emanuelepaiano/emabot/README.md

<h1>Emabot</h1>
<h2>A robot mobile with Raspberry Pi and Arduino (italian tutorials)</h2>

<div style="float:left">
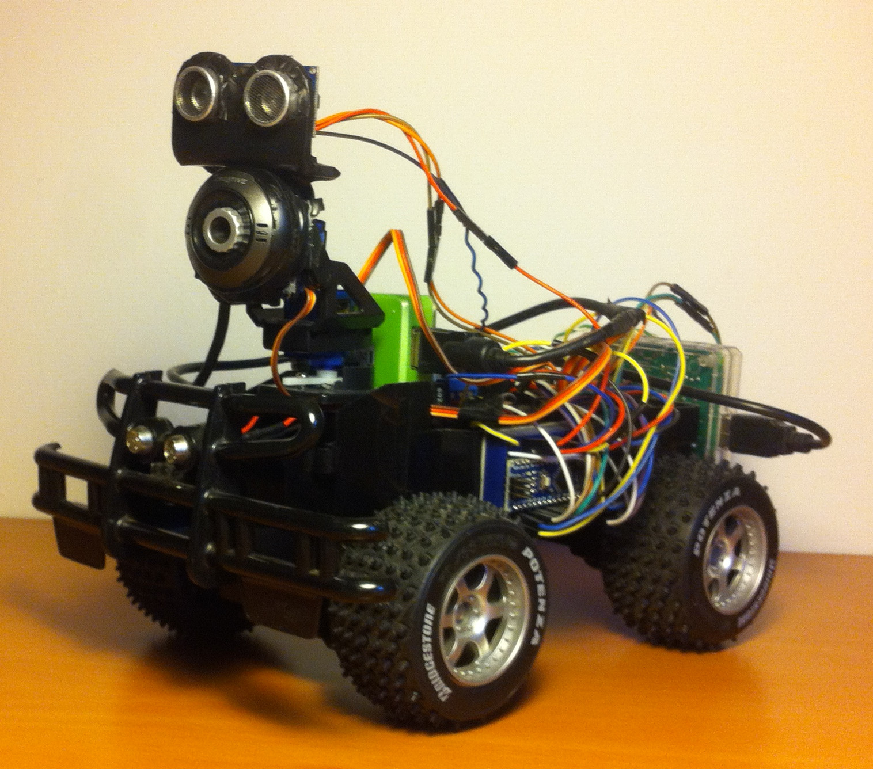
[picture p1: screenshots/01.jpg]

</div>

<div style="float:left">
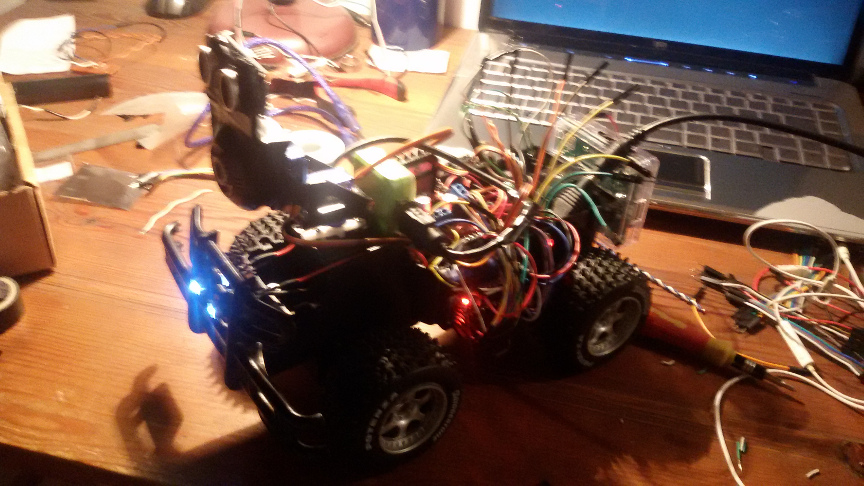
[picture p2: screenshots/06.jpg]
&nbsp
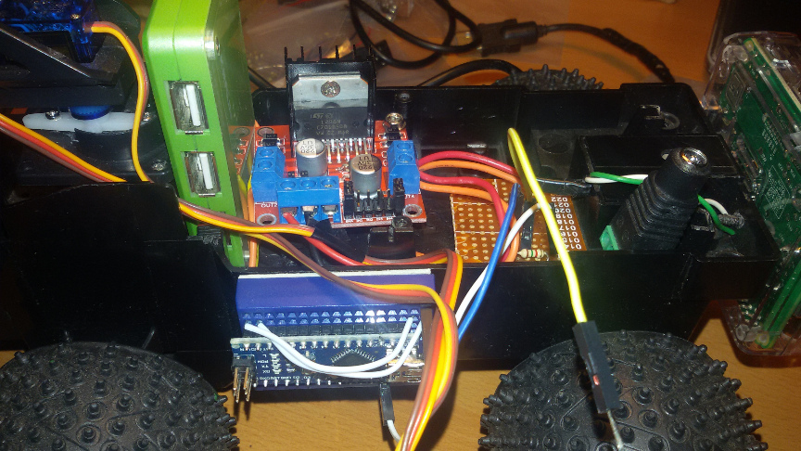
[picture p3: screenshots/07.jpg]
&nbsp
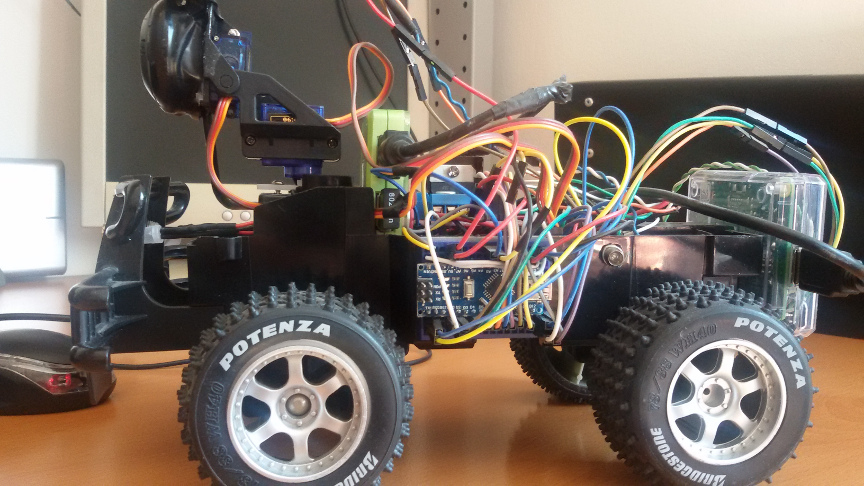
[picture p4: screenshots/08.jpg]
&nbsp
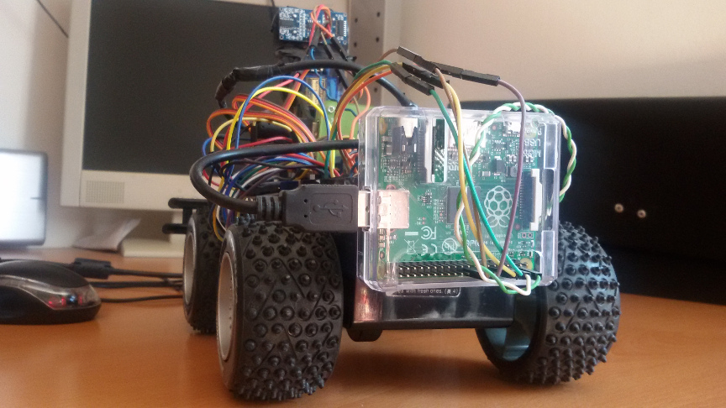
[picture p5: screenshots/09.jpg]
&nbsp

</div>

<h6>Youtube video</h6>
https://www.youtube.com/embed/CbBROWYHJkE

<h6>Tutorials</h6>
<p>Emabot Part1 ITA - 
<a href="https://github.com/emanuelepaiano/emabot/blob/master/Emabot_ITA_part%201.pdf">pdf</a>, 
<a href="https://github.com/emanuelepaiano/emabot/blob/master/markdown/robot_raspberry.markdown">markdown</a>
</p>
