emanuelepaiano/emabot/Emabot_ITA_part 1.pdf

## Costruire un robot mobile con Raspberry Pi e Arduino

Emanuele Paiano

27 aprile 2017

### 1 Licenza

L’autore declina ogni responsabilità relativa alle eventuali conseguenze (hardware danneggiato o altro) delle informazioni contenute nel presente articolo. E’ consentita la stampa, diffusione e riproduzione del testo integrale, purchè venga citata la fonte e l’autore. I sorgenti del progetto sono coperti dai termini della licenza GNU-GPL3 e possono essere riutilizzati per altri progetti non commerciali. Per eventuali chiarimenti potete contattare l’autore all’indirizzo nixw0rm@gmail.com.

### 2 Introduzione

Con l’evoluzione delle varie board di sviluppo e dei sistemi embedded, oggi è estremamente facile assemblare piccoli robot programmabili. E’ possibile tirar su delle piattaforme hardware che ci consentono di sperimentare diversi tipi di algoritmi per la robotica, come la navigazione o il semplice controllo remoto. Se consideriamo i costi contenuti dei vari componenti in commercio, ci rendiamo conto che il progetto diventa ancora più realizzabile e alla portata di molte tasche.
Intuitivamente, possiamo paragonare un semplice robot mobile ad un piccolo computer dotato di sensori e attuatori: i primi sono dispositivi di input in grado di percepire lo stato dell’ambiente, mentre i secondi possiamo considerarli dei dispositivi di output che modificano tale stato (compresa la posizione del robot), in base a delle istruzioni contenute in memoria.

1

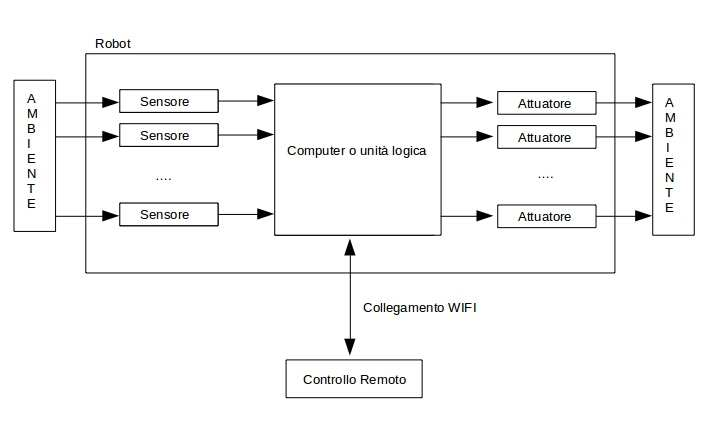
[picture p14: figure]

Prendendo spunto da una mia esperienza personale, in questa serie di articoli vedremo come realizzarne uno, equipaggiato con:

- sensori ultrasuoni per riconoscere gli ostacoli,
- webcam USB dotata di servomotori,
- altoparlante per permettergli di parlare pronunciando delle frasi preimpostate.

Il telaio può essere recuperato da una vecchia macchina radiocomandata oppure è possibile acquistarne uno già pronto. Il nostro robot avrà in tutto 4 ruote e due motorini: due posteriori per la trazione e due anteriori per lo sterzo, il quale viene gestito da un singolo motorino. La board di riferimento è Raspberry Pi accompagnata da Arduino Nano per una gestione più efficiente dei motori.
Il controllo remoto, consiste in un server tcp che gestisce i singoli comandi ricevuti da uno smartphone o pc (su cui gira il client), mentre per il flusso della webcam si farà uso di un server http per lo streaming video.
All’eventuale domanda sul perchè non ci si limita ad Arduino, la risposta metterebbe in evidenza tutti i vantaggi di avere installato Linux in un robot: Raspbian lo rende scalabile e flessibile, permettendo di aggiungere o implementare diverse funzionalità aggiuntive, tra cui:
- far parlare il robot installando espeak, noto sintetizzatore vocale per linux;
- configurare un server vpn e fare in modo che il robot venga gestito fuori dalla nostra rete locale;
- implementare un piccolo sistema di sorveglianza remota direttamente nel robot, con notifica email per eventuali movimenti sospetti (rendendolo un «robot da guardia»).

2

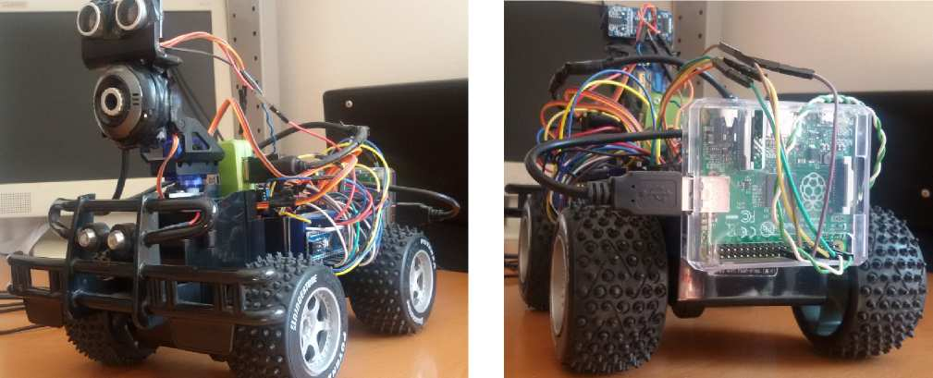
[picture p15: figure]

Figura 1: Un robot mobile realizzato con Raspberry

- possiamo scegliere, tra i linguaggi supportati da raspberry, quello che ci fa più comodo per scrivere il server;
- fare quasi tutto quello che si può fare con un raspberry (immaginate di dare un comando vocale al robot per riprodurre un mp3 in memoria).

Implementare tali caratteristiche con un microcontrollore, appare molto più complesso. Il prezzo da pagare si riversa sui consumi energetici che saranno decisamente maggiori.

### 2.1 Una prima versione: un Raspberry con le ruote

Il primo passo è quello di assemblare un «Raspberry dotato di ruote e webcam». Per ora ignoriamo servomotori e sensori, che saranno aggiunti successivamente. La lista del materiale occorrente prevede:

- Un Raspberry A+, ma andrebbe bene qualunque versione, tenendo conto però, che le versioni B e B+ hanno consumi energetici più elevati (600mAh contro 1500-3000mAh);
- Un dongle Wifi per connettere il raspi ad una rete wireless o per impostarlo come access point. Tale componente non è necessario se usiamo Raspberry Pi 3 (ha la wifi integrata);
- Un hub usb con almeno 3 porte: una per connettere la cam, un’altra per l’adattatore wifi e una di riserva. Tale componente è indispensabile se usiamo il Raspberry A+, in quanto quest’ultimo dispone di una sola porta usb;
- Un Arduino Nano, comandato da Raspberry, si occuperà di gestire il modulo motori ed eventuali attuatori aggiuntivi (luci e servomotori per la webcam).

3

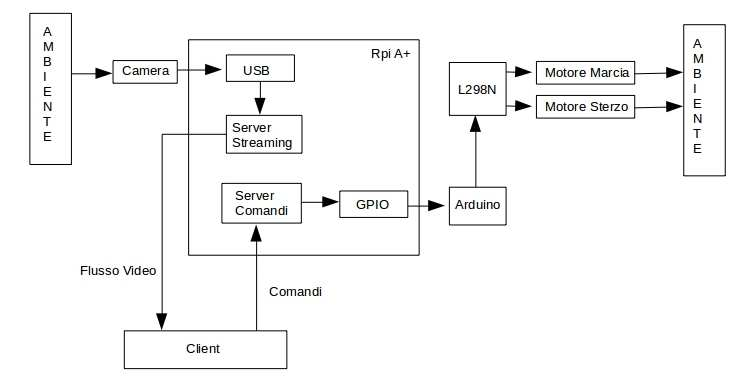
[picture p16: figure]

Figura 2: Schema di funzionamento della prima versione del robot

- Un modulo L298N che permette di gestire i motori di marcia e sterzo, oltre che ad alimentare Arduino;
- Un convertitore di livello per far comunicare Raspberry e Arduino. Raspberry lavora a 3.3 V, mentre Arduino a 5. Se non si converte tale voltaggio, si rischia di danneggiare seriamente il Raspi. Come alternativa, i più esperti potranno far uso di un partitore di tensione;
- Batteria ricaricabile da 9-12 Volt e 2500mAh. Per i test iniziali, è possibile utilizzare un alimentatore universale per notebook impostato a 12 Volt;
- Un DC Step-Down per ridurre i 12 Volt in ingresso in 5 Volt per Raspberry. Come alternativa, i più esperti potranno realizzare un regolatore di tensione apposito, utilizzando un LM7805. Ovviamente tutte le masse (GND) andranno collegate tra loro altrimenti non funzionerà nulla.

ALTERNATIVA

- Una batteria lipo da 7,4V per Arduino / Motori e un Powerbank da 5V per Raspberry, ricordando di collegare la massa (GND) del Raspberry a quella di Arduino.

Per avere un’idea del funzionamento generale del del robot, basta fare riferimento allo schema in Figura 2
Tale schema è intuitivo: la webcam è collegata ad una porta USB di Raspberry, Arduino al GPIO del raspi e i motori al modulo L298N che a sua volta sarà collegato ad Arduino. Il motivo per cui non si collega il modulo direttamente al GPIO, è dovuto al fatto che Raspberry non è un sistema realtime (a meno

4

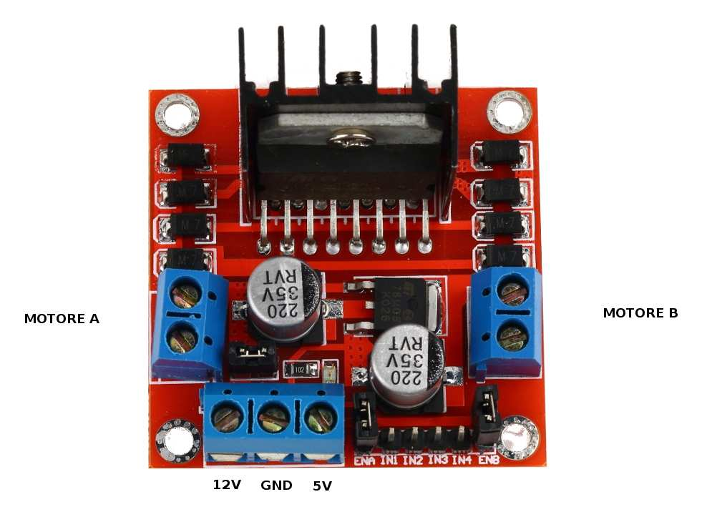
[picture p17: figure]

Figura 3: Il modulo L298N

che non si faccia uso di schede aggiuntive): ciò lo rende instabile di fronte a task che devono essere eseguiti e terminati in intervalli di tempo limitati. Infatti, può succedere che il sistema operativo dia maggiore priorità a processi che non riguardano la gestione dei motori, causando una risposta ritardata ai comandi ricevuti (per esempio, il robot potrebbe sterzare in ritardo). Arduino fa da tramite riducendo le operazioni da eseguire, quindi raspberry dovrà limitarsi ad inviare i comandi sulla porta seriale, al resto ci pensa il microcontrollore. Delegando la gestione degli attuatori, si risolve il problema dell’instabilità, dovuta all’impiego di un sistema che non sia realtime. Altre alternative (già pronte) sono le schede HAT, fatte appositamente per permettere a Raspberry di supportare Servo e Motori CC senza problemi, purtroppo tali schede non sono a disposizione dell’autore. Andiamo a vedere nel dettaglio come saranno effettuati i collegamenti di Arduino al modulo L298N.

### 2.2 Collegamento motori

La prima componente da assemblare è la parte relativa ad Arduino e i Motori CC (la parte più a destra dello schema in Figura 2), seguito dalla realizzazione di un semplice sketch. Prima di procedere, diamo un’occhiata alle caratteristiche del modulo motori.

### 2.2.1 Il modulo L298N

Il modulo L298N (figura 3), detto anche H-Bridge, è un modulo utilizzabile per la gestione dei motori a corrente continua. Esso è composto da un ingresso a 12 Volt, due uscite a 3 V per i motori, e un’uscita a 5 Volt per alimentare la scheda di controllo. Purtroppo, quest’ultima, non può essere utilizzata per alimentare

5

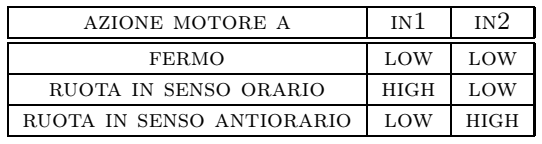
[picture p18: figure]
azione motore a; fermo; low; ruota in senso orario; high; ruota in senso antiorario

Tabella 1: Valori degli ingressi per pilotare il motore A

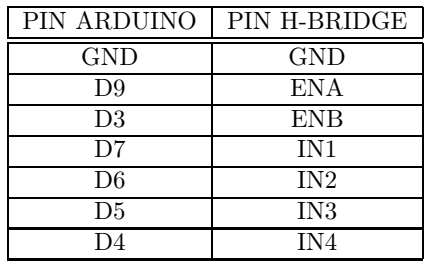
[picture p19: figure]
PIN ARDUINO; PIN H-BRIDGE; GND; ENA; ENB

Tabella 2: Collegamento pin tra H-Bridge e Arduino

Raspberry (l’amperaggio fornito è insufficiente) ma va benissimo per Arduino. Tuttavia, non sarà utilizzata per le fasi di test, infatti ad Arduino collegheremo solo la massa (GND) ma non l’alimentazione, in quanto il microcontrollore sarà alimentato dalla stessa porta USB del PC. Gli ingressi per la gestione dei motorini sono:

- Enable Motor A (ENA): E’ l’ingresso utilizzato per impostare il PWM del motore A, quindi anche la sua velocità. Se messo in corto con il pin superiore (5V+), la velocità rimarrà constante (al valore massimo). Diversamente, possiamo regolare gli impulsi da Arduino e farla variare (sfruttando il Duty Cycle); (https://it.wikipedia.org/wiki/Duty_cycle)
- Enable Motor B (ENB): vale lo stesso discorso di ENA, ma per il motore B.
- Gli ingressi IN1 e IN2 funzionano come mostrato in Tabella 1. Lo stesso discorso vale per IN3 e IN4, solo che viene gestito il motore B.

### 2.2.2 Montaggio e sketch

I collegamenti da effettuare tra i pin di Arduino e quelli del H-Bridge sono descritti in Tabella 2
In Figura 4 possiamo vedere lo schema completo. Il motore cc utilizzato è il Mabuchi FA130 a 3V (spesso presente nei giocattoli elettrici, come trenini e macchine da pista polistil), ma il modulo ne supporta anche altri tipi. Montato il circuito, possiamo pensare all’implementazione dello sketch di Arduino.

6

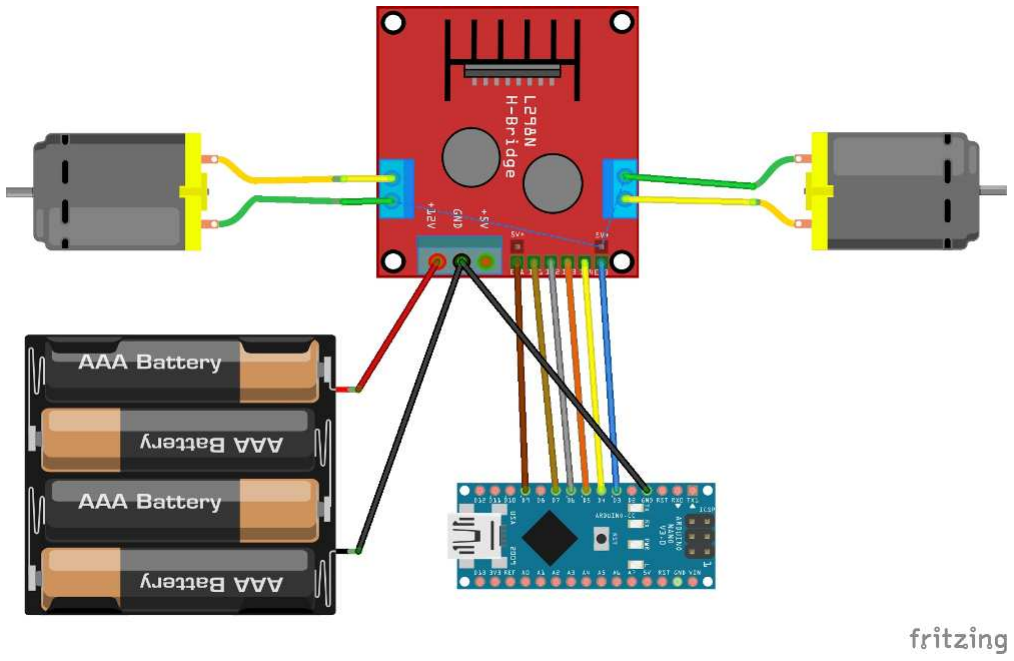
[picture p20: figure]

Figura 4: Collegamento di Arduino al modulo L298N.

7

Le funzioni che utilizzeremo sono analogWrite() per impostare il valore di ENA e quello di ENB, mentre digitalWrite() lo utilizzeremo per inviare i valori HIGH e LOW agli altri pin.
Il codice seguente è lo sketch da caricare in Arduino.

1 /∗
2 | ∗ | Car Ardu ino s im pl e s k e t c h
3 | ∗ | 2015 − | Emanuele Paiano
4 ∗/
5 | /∗ | Primo motore ∗/
6 const int enA = 9 ;
7 const int i n 1 = 7 ;
8 const int i n 2 = 6 ;
9
10 | /∗ | Secondo motore ∗/
11 const int enB = 5 ;
12 const int i n 3 = 7 ;
13 const int i n 4 = 4 ;
14
15 | /∗ | Massimo v a l o r e PWM mo tor ino d i Marcia ∗/
16 const int kMaxPwm=200;
17
18 /∗ v a l o r e PWM S t e r z o ∗/
19 const int kWheelPwm=150;
20
21 /∗ SpeedVal Max . Massimo v a l o r e d e l l e "marce" ∗/ 22 const int kMaxSpeed=5;
23
24 /∗ SpeedVal a t t u a l e ( in g e r g o marc ia ) ∗/
25 int cu r r en tSpeed =4;
26

### 27 void s e tup ( ) {

28 | /∗ | U s c i t e Modulo L298N ∗/
29 pinMode ( enA , OUTPUT) ;
30 pinMode ( enB , OUTPUT) ;
31 pinMode ( in1 , OUTPUT) ;
32 pinMode ( in2 , OUTPUT) ; 33 pinMode ( in3 , OUTPUT) ;
34 pinMode ( in4 , OUTPUT) ;
35
36 | /∗ | I n i z i a l i z z o l a comun icaz ione s e r i a l e usb a 9600 b i t /
s e c ∗/
37 S e r i a l . be gin ( 9 6 0 0 ) ;
38
39 | /∗ | Svuo to i l b u f f e r d e l l a s e r i a l e ∗/
40 S e r i a l . f l u s h ( ) ;

8

41 }
42
43

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

### 49 switch( c )

50 {
51 | /∗ | se ho l e t t o una ’A ’ vado a v a n t i ∗/

### 52 case ’A ’ :

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

### 57 case ’ a ’ :

58 r e v e r s e ( ) ;
59 S e r i a l . p r i n t l n ( "REVERSE OK" ) ;
60 break ;
61 | /∗ | se ho l e t t o una ’ s ’ mi fermo ∗/

### 62 case ’ s ’ :

63 stopMotorA ( ) ;
64 S e r i a l . p r i n t l n ( "STOP OK" ) ;
65 break ;
66
67 | /∗ | se ho l e t t o una ’L ’ g i r o a Des tra ∗/

### 68 case ’L ’ :

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

### 74 case ’ l ’ :

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

### 80 case ’ S ’ :

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

### 86 case ’+’ :

9

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

### 92 case ’−’ :

93 cu r r en tSpeed −−;
94 cu r r en tSpeed=c o n s t r a i n ( cu r r en tSpeed , 1 ,
| | kMaxSpeed ) ;
95 S e r i a l . p r i n t l n ( cu r r en tSpeed ) ;
96 break ;
97 }
98 }
99 }
100
101 /∗ Avan t i ∗/
102 void f o rw a r d ( ) {
103 stopMotorA ( ) ;
104 d i g i t a lW r i t e ( in1 , HIGH) ;
105 d i g i t a lW r i t e ( in2 , LOW) ;
106 a n al o gW ri te ( enA , ge tSpeedVal ( cu r r en tSpeed ) ) ; 107 }
108
109 /∗ recu pe r a c o r r e t t o v a l o r e d i v e l o c i t à ∗/
110 int ge tSpeedVal ( int v al u e )
111 {
112 int v al =0, mult=kMaxPwm/kMaxSpeed ;
113 v al u e=c o n s t r a i n ( value , 0 , kMaxSpeed ) ; 114 v al=v al u e ∗mult ;
115 v al=c o n s t r a i n ( val , 0 , kMaxPwm) ;
116 return v al ;
117 }
118
119 /∗ i n v e r t i marc ia ∗/
120 void r e v e r s e ( ) {
121 stopMotorA ( ) ;
122 d i g i t a lW r i t e ( in2 , HIGH) ;
123 d i g i t a lW r i t e ( in1 , LOW) ;
124 a n al o gW ri te (enA , ge tSpeedVal ( cu r r en tSpeed ) ) ; 125 }
126
127 /∗ Ferma motore d i marc ia ∗/
128 void stopMotorA ( ) {
129 d i g i t a lW r i t e ( in1 , LOW) ; 130 d i g i t a lW r i t e ( in2 , LOW) ;
| | 10

131 a n al o gW ri te ( enA , 0 ) ; 132 }
133
134 /∗ S t e r z o a d e s t r a ∗/ 135 void tu r nRi g h t ( ) {
136 s t r a i g h t ( ) ;
137 d el a y ( 1 0 0 ) ;
138 a n al o gW ri te ( enB , kWheelPwm ) ; 139 d i g i t a lW r i t e ( in3 , HIGH) ;
140 d i g i t a lW r i t e ( in4 , LOW) ;
141 }
142
143 /∗ s t e r z o a s i n i s t r a ∗/
144 void t u r n L e f t ( ) {
145 s t r a i g h t ( ) ;
146 d el a y ( 1 0 0 ) ;
147 a n al o gW ri te ( enB , kWheelPwm ) ; 148 d i g i t a lW r i t e ( in3 , LOW) ;
149 d i g i t a lW r i t e ( in4 , HIGH) ;
150 }
151
152 /∗ r a d d r i z z a s t e r z o ∗/
153 void s t r a i g h t ( ) {
154 d i g i t a lW r i t e ( in3 , LOW) ; 155 d i g i t a lW r i t e ( in4 , LOW) ;
156 a n al o gW ri te ( enB , 0 ) ;
157 }
| Il funzionamento del programma è relativamente semplice: i comandi sono
semplici caratteri ricevuti sulla porta seriale e, in base al byte ricevuto, viene richiamata una funzione corrispondente ad un’azione da eseguire (forward, reverse, turnLeft, turnRight, stop e straight). I comandi possono essere riassunti in Tabella 3.

I possibili livelli di velocità variano da 1 a 5. Si è preferito usare questi valori fittizzi (anzicchè quelli compresi tra 0 a 255), per semplificare l’aumento e la riduzione della velocità utilizzando i caratteri ’+’ e ’-’. Il livello iniziale è 4, in quanto se c’è scarsa trazione, il robot non si muove. Inoltre, per allungarne la vita, si è preferito impostare a 200 il limite massimo del pwm di marcia e a 150 quello dello sterzo: valori più alti sono inutili, data la struttura della nostra macchina (dare troppa potenza al motorino dello sterzo potrebbe essere dannoso).
Per verificare se abbiamo fatto tutto correttamente, possiamo collegare Arduino alla porta usb del PC, alimentiamo il modulo (tramite alimentatore o

11

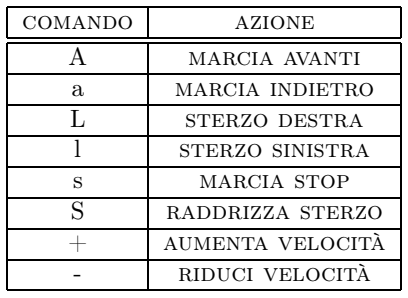
[picture p21: figure]
comando; azione; A marcia avanti; marcia indietro; L sterzo destra; sterzo sinistra; marcia stop; S raddrizza sterzo; aumenta velocità; - riduci velocità

Tabella 3: Comandi da inviare ad Arduino

pin arduino | converter hv | converter lv | pin raspi

Tabella 4: Collegamento UART arduino-convertitore-raspberry.

batterie) e proviamo ad inviare i caratteri con il monitor seriale dell’ide di Arduino, impostando la velocità a 9600bps. Se i motorini girano, e il modulo risponde correttamente ai comandi, allora possiamo passare alla tappa successiva: il collegamento del Raspberry.

### 2.3 Collegare il Raspberry

Per collegare il Raspberry, abbiamo bisogno di un convertitore dei livelli di tensione (Figura 5, in alto a destra), in particolare sul pin di ricezione del raspi (UART_RXD). L’elenco dei Pin è visibile in Figura 5.
Il collegamento da realizzare è di tipo UART: consiste nel collegare il Pin TX di Arduino al Pin UART_RXD di Raspberry, e il pin UART_TXD al pin RX di Arduino come mostrato in figura 6, facendo riferimento ai pin in Tabella 4. Il metodo è molto simile a quello della costruzione di un cavo null modem, ma le controparti hanno livelli di tensione differenti (Arduino lavora a 5V, mentre Raspberry a 3,3).
Collegato il raspberry, non resta che collegare anche il pin vin di Arduino al pin 5V del modulo L298N (staccate arduino dalla usb del pc), come mostrato in figura 7. Per alimentare raspberry, possiamo usare un alimentatore da smartphone (purchè sia a 5V), almeno per le fasi di test. Successivamente, si farà uso di un modulo dc step down: si prenderà parte della tensione globale del sistema, e la si ridurrà a 5 V per Raspberry. In questo modo, avremo due diramazioni a partire dalla sorgente a 12V: una a 5V per Raspberry e l’altra a

### 12 per alimentare il modulo motori (insieme al microcontrollore). L’importante

è che fate arrivare almeno 9V (meglio 12) e 2400mAh in ingresso.

12

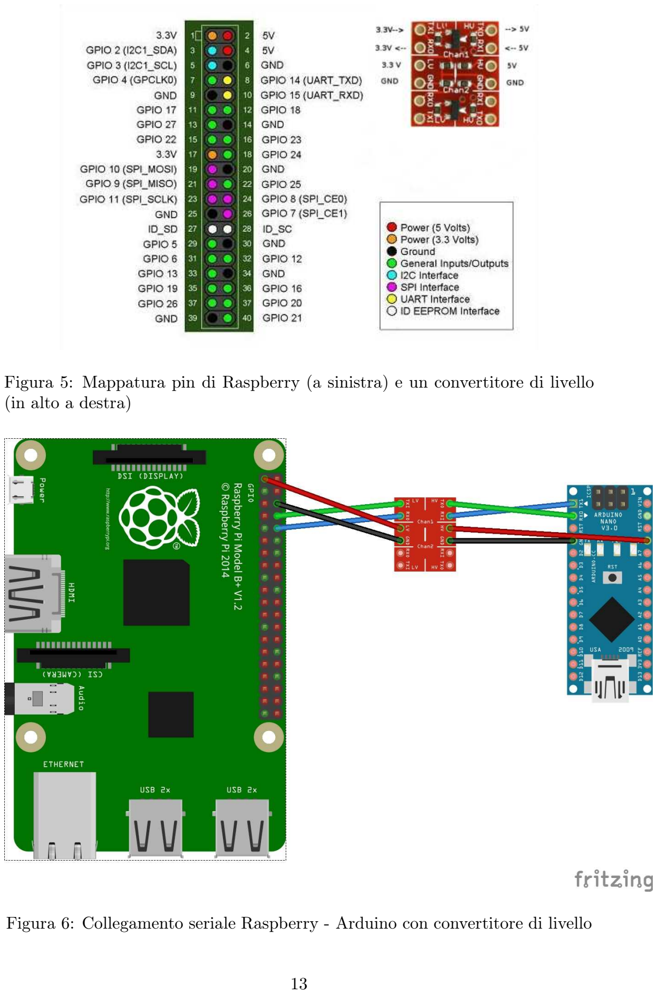
[picture p22: page 13]

Figura 5: Mappatura pin di Raspberry (a sinistra) e un convertitore di livello (in alto a destra)

Figura 6: Collegamento seriale Raspberry - Arduino con convertitore di livello

13

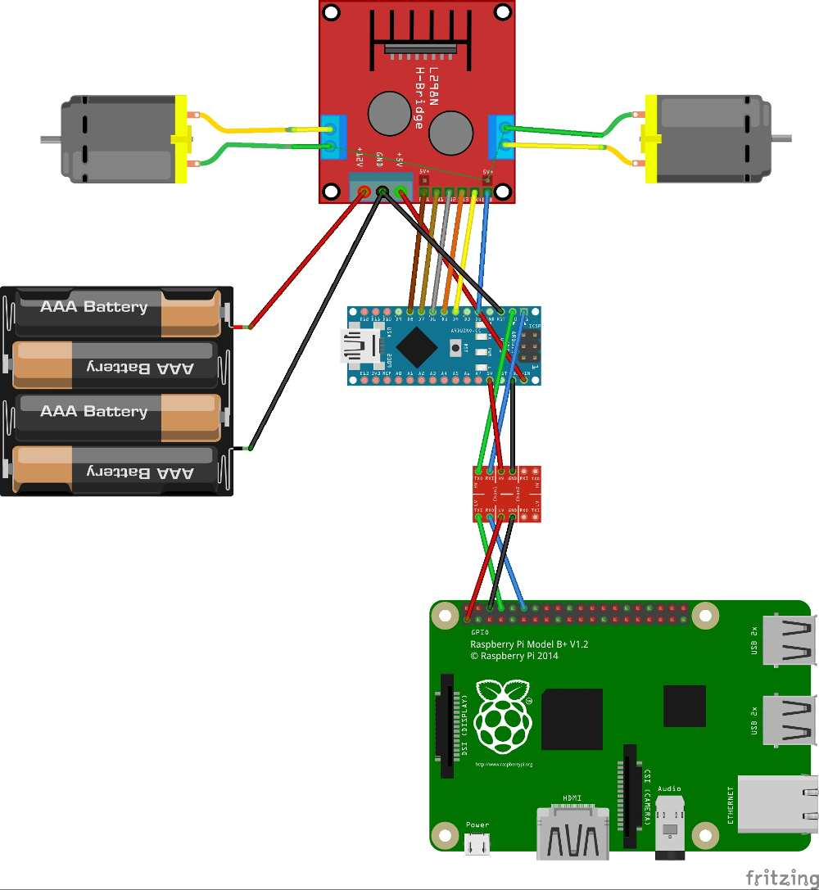
[picture p23: figure]

Figura 7: Il circuito nel complesso: Arduino alimentato direttamente dall’H-bridge, mentre Raspberry sarà alimentato a parte. Da non dimenticare il collegamento GND di raspberry a quello di tutto il circuito.

14

### 2.4 Prima configurazione e test del collegamento

Dopo aver configurato Raspbian, ci limiteremo a testare i motorini da Raspbian. Forse, non tutti sanno che sulla linea seriale UART, di default c’è un attivo un processo getty che permette il login: dobbiamo disattivarlo o il nostro circuito avrà dei malfunzionamenti. Per fare ciò apriamo il file /etc/inittab e troviamo la stringa

T0 : 2 3 : respawn : / s bi n / g e t t y −L ttyAMA0 115200 v t1 0 0

possiamo disattivarla aggiungendo il carattere # per commentarla

#T0 : 2 3 : respawn : / s bi n / g e t t y −L ttyAMA0 115200 v t1 0 0

e salviamo il file. Inoltre, quando raspbian si avvia, tutte le informazioni vengono inviate sulla porta seriale, in quanto tale parametro viene passato al boot. Per disattivarlo, apriamo il file /boot/cmdline.txt e troviamo la riga simile a questa

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

e rimuoviamo tutti i riferimenti a ttyAMA0, nel nostro caso la riga diventa

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

salviamo il file e riavviamo raspberry. Ovviamente tali impostazioni possono variare da una versione all’altra di raspbian, ma spesso sono simili. Ora si lancia minicom sulla porta /dev/ttyAMA0 con una velocità a 9600bps:

minicom −b 9600 −o −D / dev /ttyAMA0

digitando i comandi, possiamo inviare i caratteri e vedere i motorini funzionare.

### 2.5 Riepilogo e conclusioni

Siamo partiti dal collegare i motori al modulo L298N. Abbiamo realizzato uno sketch per Arduino che riceve caratteri ascii e genera segnali high e low da mandare al modulo motori, per poi interfacciare tutto con raspberry in modo da ricevere i comandi da minicom.
A questo punto, possiamo pensare alla parte applicativa: l’idea è quella di scrivere un insieme di librerie e classi in un linguaggio che, agendo sul file /dev/ttyAMA0, gestisca i servo della cam e i motori di marcia. Si potrebbe pensare di scrivere una classe per ogni sensore e attuatore, in modo tale da arrivare a programmare il robot in stile oop, arrivando anche ad implementare un server tcp in qualunque linguaggio. L’obiettivo finale di questo progetto, è quello di arrivare a ricevere i caratteri ascii direttamente da un client remoto.
I comandi saranno inviati da un’apposita app Android, configurata per pilotare il robot via wlan. Su Google Play alcune sono gratuite e con supporto streaming da cam: una app che fa a caso nostro, può essere WIFI TCP/UDP Controller. (https://play.google.com/store/apps/details?id=udpcontroller.nomal&hl=it)

15
