emanuelepaiano/emabot/screenshots/02.jpg

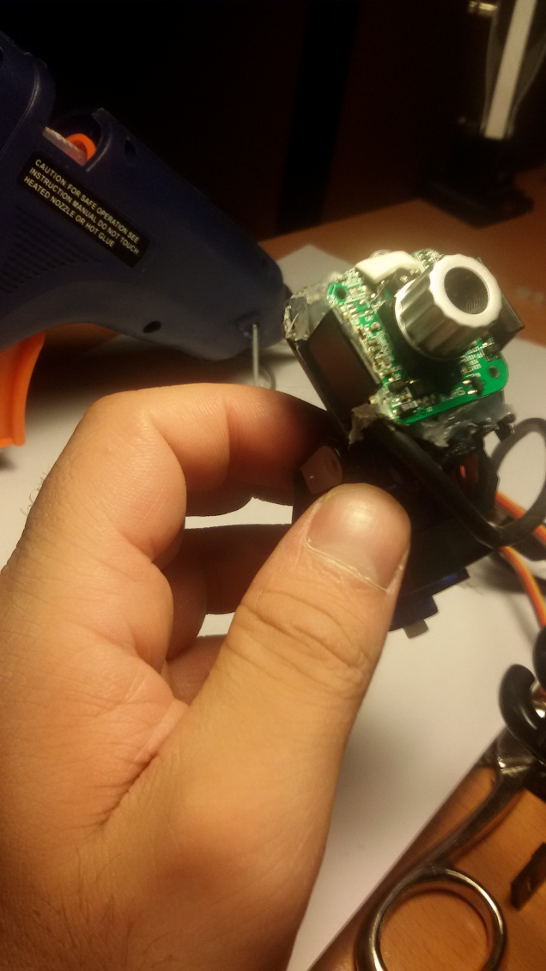
screenshots/02.jpg
