emanuelepaiano/emabot/screenshots/03.jpg

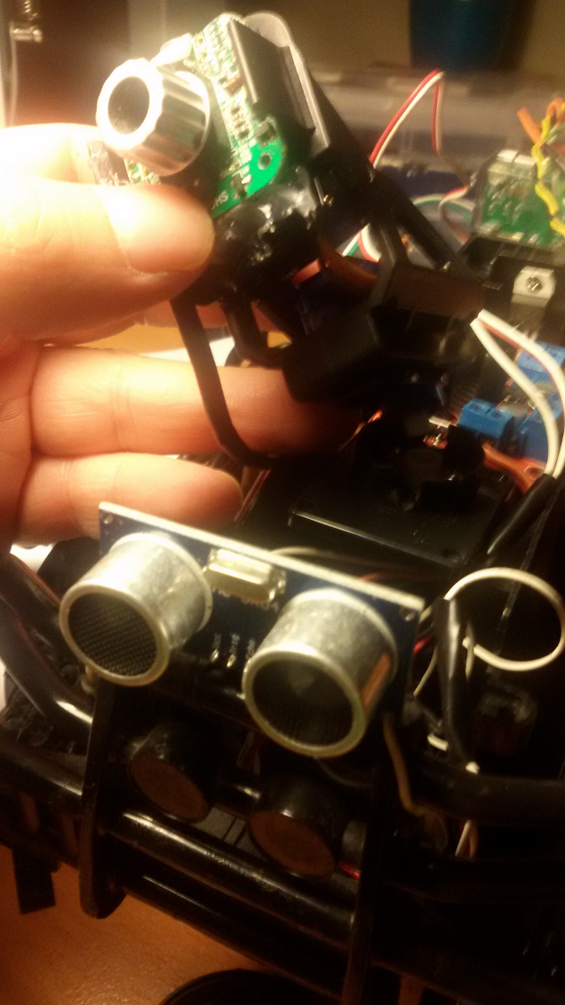
screenshots/03.jpg
