emanuelepaiano/emabot/screenshots/04.jpg

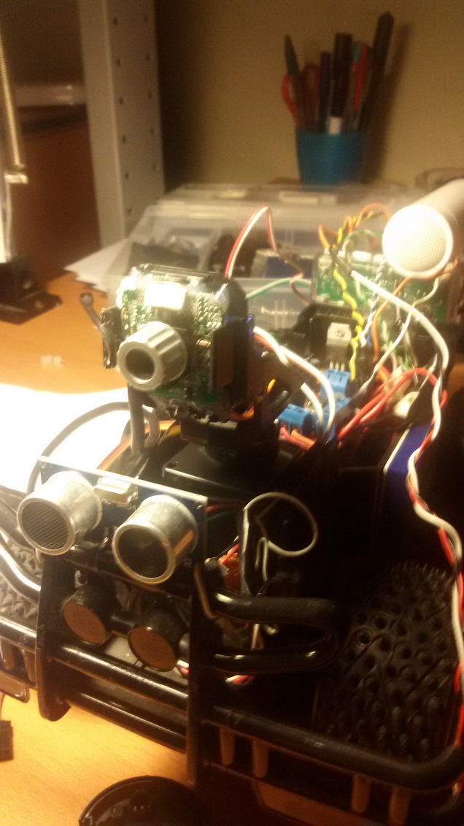
screenshots/04.jpg
