emanuelepaiano/emabot/screenshots/05.jpg

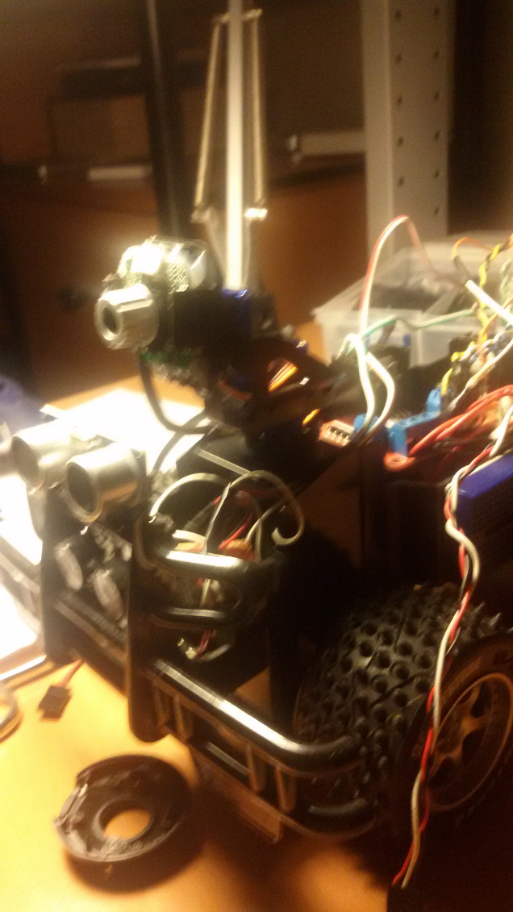
screenshots/05.jpg
