emanuelepaiano/emabot/screenshots/9.jpg

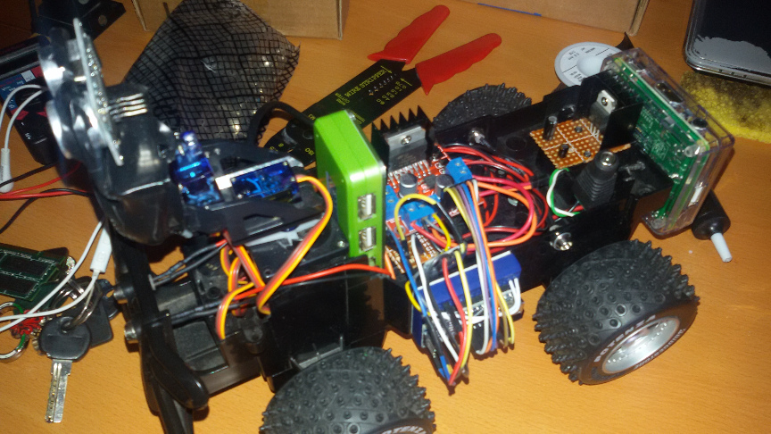
screenshots/9.jpg
