emanuelepaiano/emabot/screenshots/10.jpg

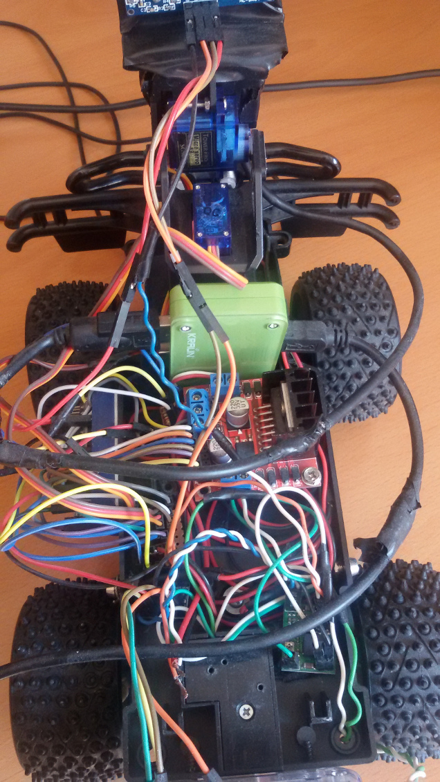
screenshots/10.jpg
